MouaadO/synchronous-buck-converter/bom/Purchasing_BOM.xlsx

Synchronous buck converter · Bill of materials
37.8–58.8 V → 14.5 V / 4 A · 100 kHz · all through-hole · IFP Powertrain mini-project 2 · BOM matched to the LTspice file Project_2_saving.asc
 | Total excl. VAT | €42.97
 | VAT rate | 20%
 | Total incl. VAT | €51.57
Schematic ref (LTspice) | Simulated model | Description | Manufacturer | Manufacturer PN | Order qty | Retailer | Retailer PN | Unit € excl. VAT | Line € excl. VAT | Order link
Power stage
Lin | 10µ | 10 µH inductor · Irms 2.7 A · Isat 6.7 A · 48 mΩ | Bourns | RLB0914-100KL | 1 | Farnell | 2321765 | €0.340 | €0.34 | Open Farnell ↗ (https://fr.farnell.com/bourns/rlb0914-100kl/inductance-10uh-2-7a-10-radial/dp/2321765)
Cin, Cout | 100µ | 100 µF capacitor · 100 V · low-ESR electrolytic (FR series) · 1.5 A ripple at 100 kHz / 105 °C · ESR 84 mΩ · Ø10×20 mm · 5 mm pitch | Panasonic | EEU-FR2A101B | 2 | Mouser | 667-EEU-FR2A101B | €1.220 | €2.44 | Open Mouser ↗ (https://www.mouser.fr/ProductDetail/Panasonic/EEU-FR2A101B?qs=u16ybLDytRZBZOsu6DbX5Q%3D%3D)
C7 | 10µ | 10 µF capacitor · 100 V · 20% electrolytic · damping branch | Panasonic | ECA2AM100 | 1 | Farnell | 9693912 | €0.210 | €0.21 | Open Farnell ↗ (https://fr.farnell.com/panasonic/eca2am100/cap-10-f-100v-20/dp/9693912)
R10 | 0.5 | 0.5 Ω resistor · 5% · 1 W | Yageo | FMP100JR-52-0R51 | 1 | Mouser | 603-FMP100JR-52-0R51 | €0.335 | €0.34 | Open Mouser ↗ (https://www.mouser.fr/fr/ProductDetail/YAGEO/FMP100JR-52-0R51?qs=oypCK0zG324JEEoMrYb%2F4w%3D%3D)
M1, M2 | IPP086N10N3 | N-MOSFET · 100 V · 8.6 mΩ · 80 A · Qg 55 nC · TO-220 | Infineon | IPP086N10N3GXKSA1 | 2 | Farnell | 2709893 | €2.650 | €5.30 | Open Farnell ↗ (https://fr.farnell.com/search?st=2709893)
D5 | MBRS1100 | Schottky rectifier · 100 V · 1 A · DO-41 | onsemi | MBR1100RLG | 1 | Mouser | 863-MBR1100RLG | €0.697 | €0.70 | Open Mouser ↗ (https://www.mouser.fr/fr/ProductDetail/onsemi/MBR1100RLG?qs=3JMERSakebqji%252BYhJ0BmMg%3D%3D)
Rshunt, Rshunt2 | 10m | 10 mΩ current sense resistor · 1% | Riedon (Bourns) | MT2B-0R01F1 | 2 | DigiKey | 696-1734-ND | €2.410 | €4.82 | Open DigiKey ↗ (https://www.digikey.fr/fr/products/detail/riedon-products-by-bourns/MT2B-0R01F1/6021851)
D11 | BZX84C15L | Zener Diodes 15 Volt 1.3 Watt | Vishay Semiconductors | 1N4744A-TAP | 1 | Mouser | 78-1N4744A-TAP | €0.335 | €0.34 | Open Mouser ↗ (https://www.mouser.fr/en/ProductDetail/Vishay-Semiconductors/1N4744A-TAP?qs=aho4taYYNurtiIjeOjc3Cg%3D%3D)
Gate drivers (M1 high side, M2 low side)
D1 | MMSD4148 | Ultrafast diode · 200 V · 1 A · 50 ns · DO-41 (bootstrap) | Vishay | UF4003-E3/54 | 5 | Farnell | 9551646 | €0.706 | €3.53 | Open Farnell ↗ (https://fr.farnell.com/vishay/uf4003-e3-54/diode-fast-1a-200v/dp/9551646)
C1 | 1µ | 1 µF capacitor · 50 V · X7R · 10% (bootstrap) | KEMET | C330C105K5R5TA7301 | 1 | Mouser | 80-C330C105K5R7301 | €0.576 | €0.58 | Open Mouser ↗ (https://www.mouser.fr/fr/ProductDetail/KEMET/C330C105K5R5TA7301?qs=17iMOMbff9UVwtQMImnwKQ%3D%3D)
Q1, Q2, Q3, Q5, Q7, Q8 | BC846B / 2SC4061K | NPN transistor · 160 V · 600 mA · 0.625 W · hFE ≥ 80 (all NPN: inverters, level shift, totem tops) | onsemi | 2N5551TA | 6 | DigiKey | 2N5551TAFSCT-ND | €0.270 | €1.62 | Open Digikey ↗ (https://www.digikey.fr/fr/products/detail/onsemi/2N5551TA/973959)
Q4, Q6 | BC556B | PNP transistor · 150 V · 600 mA · 0.625 W · complement of 2N5551 (totem bottoms) | onsemi | 2N5401YBU | 2 | DigiKey | 2N5401YBUOS-ND | €0.260 | €0.52 | Open DigiKey ↗ (https://www.digikey.com/en/products/detail/onsemi/2N5401YBU/975298)
D8, D9, D10 | D (default) | Small-signal diode · 100 V · 150 mA · 4 ns · DO-35 | Vishay | 1N4148-TAP | 3 | Mouser | 78-1N4148-TAP | €0.224 | €0.67 | Open Mouser ↗ (https://www.mouser.fr/fr/ProductDetail/Vishay-Semiconductors/1N4148-TAP?qs=j6bfm3UnQnzzWicd%2FOfTEw%3D%3D)
R7, R31 | 10 | 10 Ω resistor · 1% · 0.25 W (gate) | Yageo | MFR-25FBF52-10R | 2 | Mouser | 603-MFR-25FBF52-10R | €0.086 | €0.17 | Open Mouser ↗ (https://www.mouser.fr/fr/ProductDetail/YAGEO/MFR-25FBF52-10R?qs=oAGoVhmvjhxFEeFiVj%2FuSQ%3D%3D)
R4, R8, R26 | 4.7k | 4.7 kΩ resistor · 1% · 0.25 W | Yageo | MFR-25FBF52-4K7 | 3 | Mouser | 603-MFR-25FBF52-4K7 | €0.095 | €0.29 | Open Mouser ↗ (https://www.mouser.fr/fr/ProductDetail/YAGEO/MFR-25FBF52-4K7?qs=oAGoVhmvjhyEuU2iU0uA4w%3D%3D)
R9, R23, R29 | 2.2k | 2.2 kΩ resistor · 1% · 0.25 W | Yageo | MFR25SFTF52-2K2 | 3 | DigiKey | MFR25SFTF52-2K2 | €0.100 | €0.30 | Open DigiKey ↗ (https://www.digikey.com/en/products/detail/yageo/MFR25SFTF52-2K2/9144509)
C2, C5, C8, C9, C10 | 1n | 1 nF capacitor · 50 V · X7R · 10% (speed-up) | Vishay | K102K15X7RF5TL2 | 5 | Mouser | 594-K102K15X7RF5TL2 | €0.224 | €1.12 | Open Mouser ↗ (https://www.mouser.fr/fr/ProductDetail/Vishay-BC-Components/K102K15X7RF5TL2?qs=YhDfSRCt1jTMC0SrHWnr8A%3D%3D)
Shared resistors
R2, R5, R15, R16, R22, R24, R25, R27, R30, Rgate1, Rgate2 | 10k | 10 kΩ resistor · 1% · 0.25 W | Yageo | MFR-25FBF52-10K | 11 | Mouser | 603-MFR-25FBF52-10K | €0.086 | €0.95 | Open Mouser ↗ (https://www.mouser.fr/fr/ProductDetail/YAGEO/MFR-25FBF52-10K?qs=oAGoVhmvjhxY0mVN9GL5Pg%3D%3D)
R12, R17, R20 | 1k | 1 kΩ resistor · 1% · 0.25 W | Yageo | MFR-25FBF52-1K | 3 | Mouser | 603-MFR-25FBF52-1K | €0.086 | €0.26 | Open Mouser ↗ (https://www.mouser.fr/fr/ProductDetail/YAGEO/MFR-25FBF52-1K?qs=oAGoVhmvjhwCAC47ReWjsQ%3D%3D)
Measurements for the Arduino
R1 | 120k | 120 kΩ resistor · 1% · 0.25 W (Vin ÷13) | Yageo | MFR-25FBF52-120K | 1 | Mouser | 603-MFR-25FBF52-120K | €0.181 | €0.18 | Open Mouser ↗ (https://www.mouser.fr/fr/ProductDetail/YAGEO/MFR-25FBF52-120K?qs=gt1LBUVyoHklbx%2FXO5OUuA%3D%3D)
R3 | 30k | 30.1 kΩ resistor · 1% · 0.25 W (Vout ÷4) | Yageo | MFR-25FBF52-30K1 | 1 | Mouser | 603-MFR-25FBF52-30K1 | €0.086 | €0.09 | Open Mouser ↗ (https://www.mouser.fr/fr/ProductDetail/YAGEO/MFR-25FBF52-30K1?qs=oAGoVhmvjhzLhbq61dvLWw%3D%3D)
R13, R14 | 4.99k | 4.99 kΩ resistor · 1% · 0.25 W | Yageo | MFR-25FBF52-4K99 | 2 | Mouser | 603-MFR-25FBF52-4K99 | €0.086 | €0.17 | Open Mouser ↗ (https://www.mouser.fr/fr/ProductDetail/YAGEO/MFR-25FBF52-4K99?qs=oAGoVhmvjhxwNFLO0SXfyA%3D%3D)
R11, R21 | 100k | 100 kΩ resistor · 0.1% · 0.25 W | SEI Stackpole | RNF14BTC100K | 2 | Mouser | 708-RNF14BTC100K | €0.108 | €0.22 | Open Mouser ↗ (https://www.mouser.fr/fr/ProductDetail/SEI-Stackpole/RNF14BTC100K?qs=IPgv5n7u5QaLRFL3DdmKJA%3D%3D)
R18 | 100k | 100 kΩ resistor · 1% · 0.25 W | Yageo | MFR-25FBF52-100K | 1 | Mouser | 603-MFR-25FBF52-100K | €0.086 | €0.09 | Open Mouser ↗ (https://www.mouser.fr/fr/ProductDetail/YAGEO/MFR-25FBF52-100K?qs=oAGoVhmvjhxAqZbyE%2Fs9bg%3D%3D)
R19 | 2k | 2 kΩ resistor · 1% · 0.25 W | Yageo | MFR-25FBF52-2K | 1 | Mouser | 603-MFR-25FBF52-2K | €0.086 | €0.09 | Open Mouser ↗ (https://www.mouser.fr/fr/ProductDetail/YAGEO/MFR-25FBF52-2K?qs=oAGoVhmvjhym1upYmL0LFQ%3D%3D)
U1, U2, U4 (+1 spare) | LT1490 | Dual Over-The-Top op amp · 44 V inputs · rail-to-rail | Analog Devices | LT1490ACN8#PBF | 2 | Farnell | LT1490ACN8#PBF | €5.280 | €10.56 | Open Farnell ↗ (https://fr.farnell.com/search?st=LT1490ACN8%23PBF)
D2, D3, D4, D6, D7 | UMZ5_1N | 5.1 V Zener diode · 500 mW · DO-35 (ADC clamp) | Vishay | 1N5231B-TR | 5 | Mouser | 78-1N5231B | €0.421 | €2.10 | Open Mouser ↗ (https://www.mouser.fr/fr/ProductDetail/Vishay-Semiconductors/1N5231B-TR?qs=TNTIDjy6APpam96idN6gNg%3D%3D)
C3 | 1.2n | 1.2 nF ceramic capacitor · 200 V | KEMET | C317C122J2G5TA | 1 | Mouser | 80-C317C122J2G5TA | €0.636 | €0.64 | Open Mouser ↗ (https://www.mouser.fr/c/?q=C315C122F2G5TA)
C4 | 2.2n | 2.2 nF capacitor · 25 V · C0G · 1% (filter) | KEMET | C315C222F3G5TA | 1 | Mouser | 80-C315C222F3G5TA | €1.190 | €1.19 | Open Mouser ↗ (https://www.mouser.fr/fr/ProductDetail/KEMET/C315C222F3G5TA?qs=h3%2Fj8evtlm1j8Co3p3vnQw%3D%3D)
C6 | 100n | 100 nF capacitor · 50 V · X7R · 10% | Vishay | K104K15X7RF5TL2 | 1 | Mouser | 594-K104K15X7RF5TL2 | €0.267 | €0.27 | Open Mouser ↗ (https://www.mouser.fr/fr/ProductDetail/Vishay-BC-Components/K104K15X7RF5TL2?qs=sYfpZ29HcUR83i3HiPAFlA%3D%3D)
Connectors
Headers 10-pin ×2 | — (not simulated) | Male header · 1×10 · 2.54 mm · tin | Wurth Elektronik | 61304011121 | 1 | Mouser | 710-61304011121 | €1.320 | €1.32 | Open Mouser ↗ (https://www.mouser.fr/fr/ProductDetail/Wurth-Elektronik/61304011121?qs=PhR8RmCirEZJqAFOTF3fMQ%3D%3D)
Supply terminals ×3 | — (not simulated) | Terminal block · screw type · 2 pos · 5.08 mm | Same Sky | TB007-508-02BE | 3 | DigiKey | TB007-508-02BE | €0.530 | €1.59 | Open DigiKey ↗ (https://www.digikey.fr/fr/products/detail/same-sky-formerly-cui-devices/TB007-508-02BE/10064127)
Heat sink for M1 | — (not simulated) | Heat Sinks Channel Heat Sink for TO220, Vertical, 24.4 Degree C/W | Aavid | 577202B04000G | 1 | Mouser | 532-577202B04000G | €1.090 | €1.09 | Open Mouser ↗ (https://www.mouser.fr/en/ProductDetail/Aavid/577202B04000G?qs=UkxmsQ8q2oXEh26f6ITVdQ%3D%3D)
