MouaadO/synchronous-buck-converter/pcb/3dmodels/M3_Heatsink_Assembly_Hardware.step

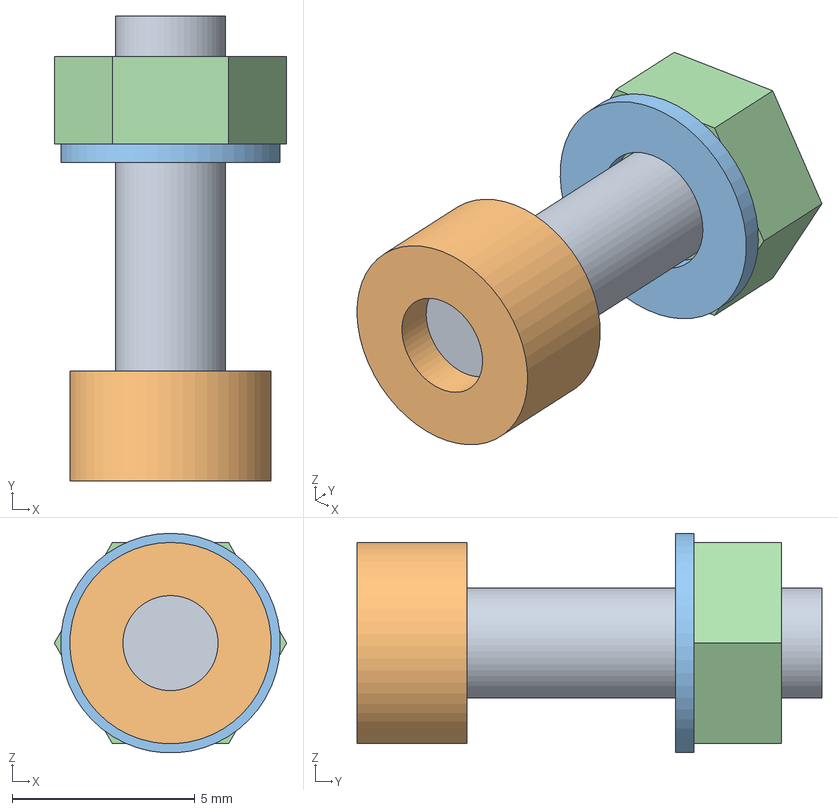
[picture p9: CAD file, 2026-11-05]
pcb/3dmodels/M3_Heatsink_Assembly_Hardware.step
6.35 x 12.7 x 5.99 mm
