MouaadO/synchronous-buck-converter/pcb/3dmodels/M1_Heatsink_Assembly_Preview.step

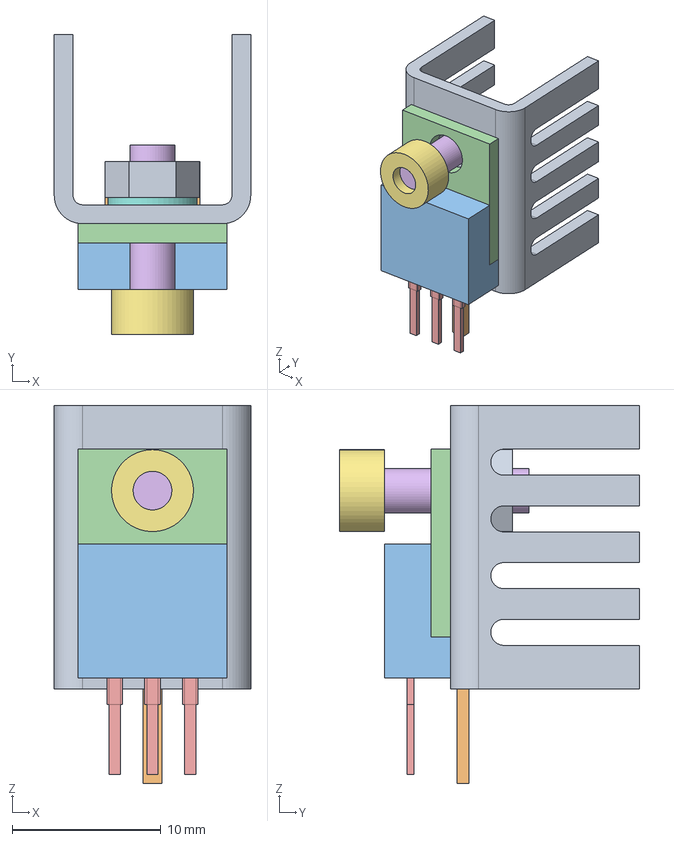
[picture p10: CAD file, 2026-11-05]
pcb/3dmodels/M1_Heatsink_Assembly_Preview.step
13.2 x 20.1 x 25.4 mm
