MouaadO/synchronous-buck-converter/pcb/3dmodels/Manufacturer_CAD/TB007-508-02BE.step

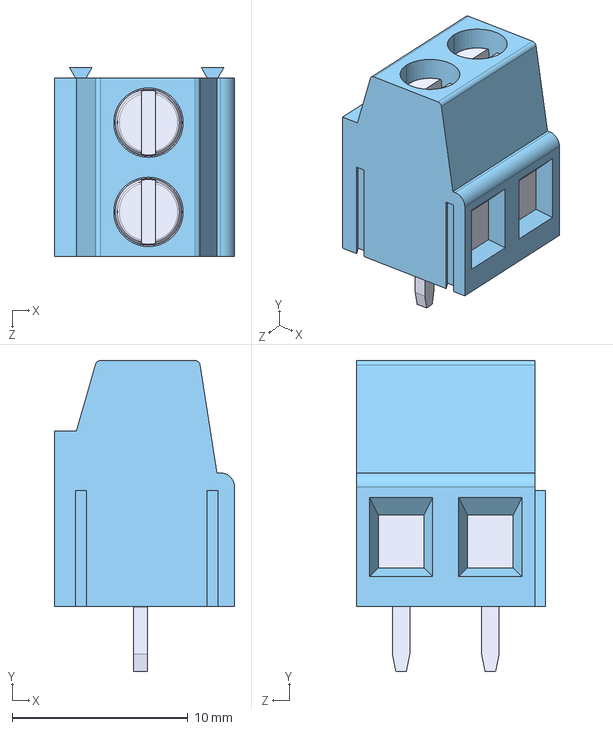
[picture p11: CAD file, 2026-11-05]
pcb/3dmodels/Manufacturer_CAD/TB007-508-02BE.step
10.2 x 17.7 x 10.8 mm
