MouaadO/synchronous-buck-converter/pcb/3dmodels/Boyd_577202B04000G_Detailed.step

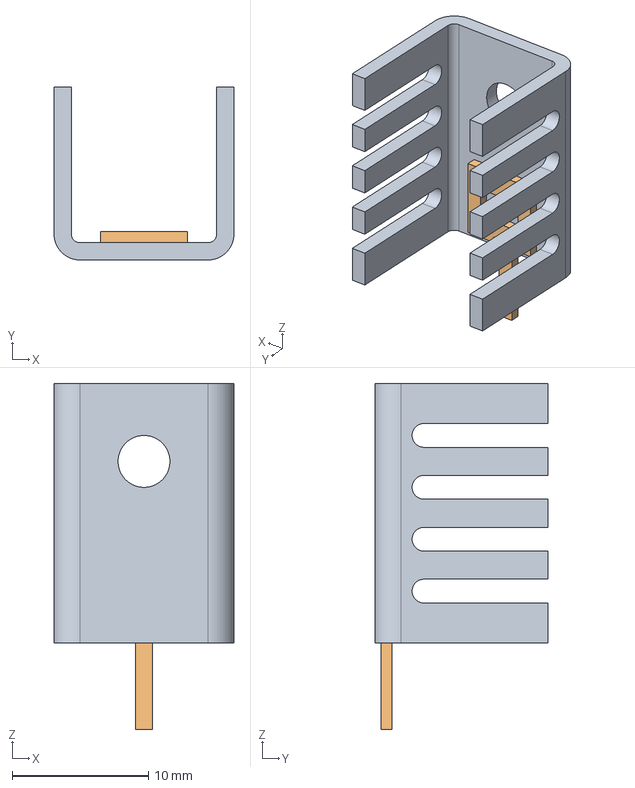
[picture p12: CAD file, 2026-11-05]
pcb/3dmodels/Boyd_577202B04000G_Detailed.step
13.2 x 12.7 x 25.4 mm
