MouaadO/synchronous-buck-converter/pcb/3dmodels/Manufacturer_CAD/C330C105K5R5TA7301.step

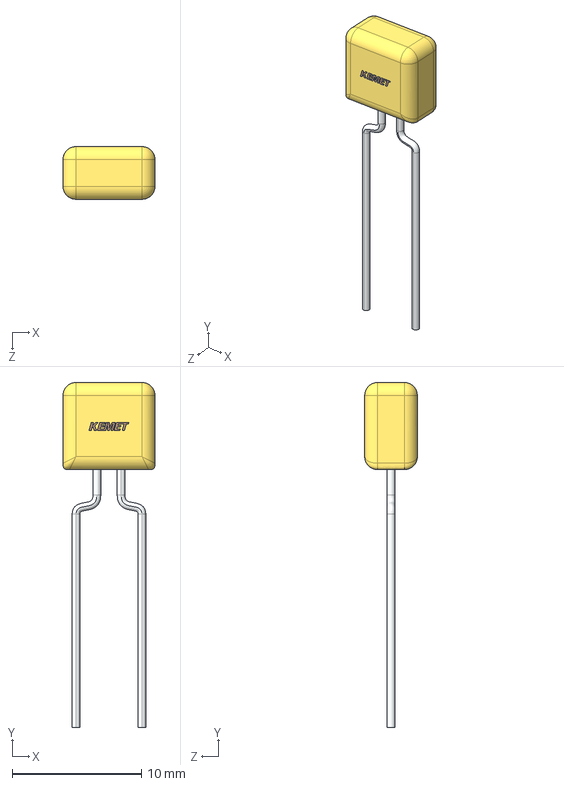
[picture p13: CAD file, 2026-11-05]
pcb/3dmodels/Manufacturer_CAD/C330C105K5R5TA7301.step
7.11 x 26.7 x 4.08 mm
