MouaadO/synchronous-buck-converter/pcb/3dmodels/Manufacturer_CAD/C317C122J2G5TA.step

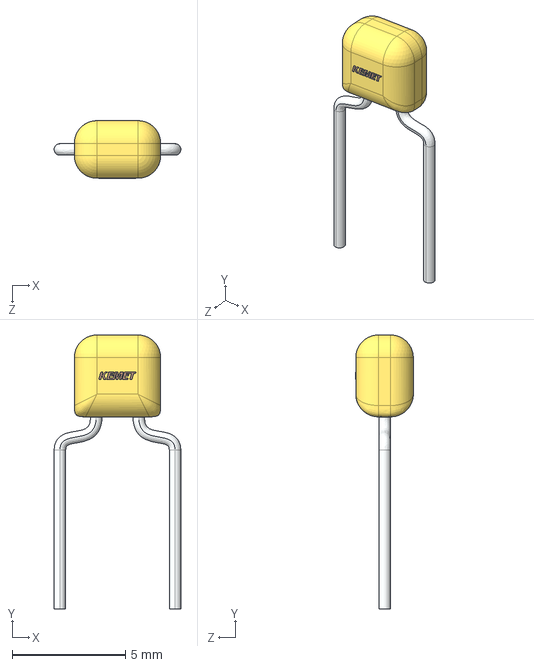
[picture p14: CAD file, 2026-11-05]
pcb/3dmodels/Manufacturer_CAD/C317C122J2G5TA.step
5.59 x 12.1 x 2.54 mm
