MouaadO/synchronous-buck-converter/pcb/3dmodels/Infineon_IPP086N10N3G_Mounted.step

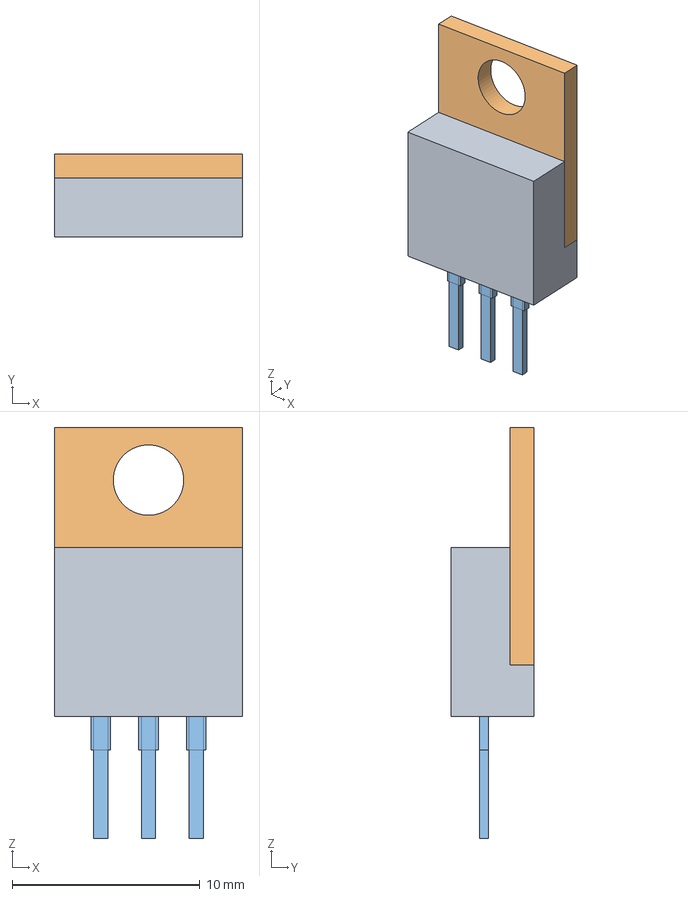
[picture p15: CAD file, 2026-11-05]
pcb/3dmodels/Infineon_IPP086N10N3G_Mounted.step
10.0 x 4.44 x 21.9 mm
