MouaadO/synchronous-buck-converter/pcb/3dmodels/Manufacturer_CAD/C315C222F3G5TA.step

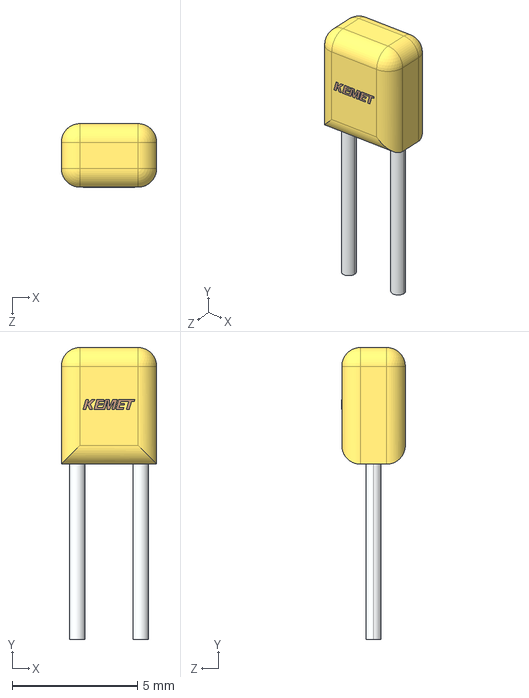
[picture p16: CAD file, 2026-11-05]
pcb/3dmodels/Manufacturer_CAD/C315C222F3G5TA.step
3.81 x 11.7 x 2.54 mm
