MouaadO/synchronous-buck-converter/simulation/Newinputfilter.asc

C1: cap; 1µ
C2: cap; 1n
C3: cap; 1.2n
C4: cap; 2.2n
C5: cap; 1n
C6: cap; 100n
C8: cap; 1n
C9: cap; 1n
C10: cap; 1n
Cin: cap; 100µ
Cout: cap; 100µ
D1: diode; MMSD4148
D2: zener; UMZ5_1N
D3: zener; UMZ5_1N
D4: zener; UMZ5_1N
D5: schottky; MBRS1100
D6: zener; UMZ5_1N
D7: zener; UMZ5_1N
D8: diode
D9: diode
D10: diode
D11: zener; BZX84C15L
Lin: ind; 10µ; Rser=1m
Lout: ind; 130µ; Rser=1m
M1: nmos; IPP086N10N3
M2: nmos; IPP086N10N3
Q1: npn; BC846B
Q2: npn; BC846B
Q3: npn; 2SC4061K
Q4: pnp; BC556B
Q5: npn; BC846B
Q6: pnp; BC556B
Q7: npn; 2SC4061K
Q8: npn; BC846B
R1: res; 120k
R2: res; 10k
R3: res; 30k
R4: res; 4.7k
R5: res; 10k
R7: res; 10
R8: res; 4.7k
R9: res; 2.2k
R10: res; 0.5
R11: res; 100k
R12: res; 1k
R13: res; 4.99k
R14: res; 4.99k
R15: res; 10k
R16: res; 10k
R17: res; 1k
R18: res; 100k
R19: res; 2k
R20: res; 1k
R21: res; 100k
R22: res; 10k
R23: res; 2.2k
R24: res; 10k
R25: res; 10k
R26: res; 4.7k
R27: res; 10k
R29: res; 2.2k
R30: res; 10k
R31: res; 10
Rgate1: res; 10k
Rgate2: res; 10k
Rload: res; 3.625
Rshunt2: res; 10m
Rshunt: res; 10m
U1: LT1490
U2: LT1490
U4: LT1490
V1: voltage; PULSE(0 5 0 10n 10n {Ton} {T})
V2: voltage; PULSE(0 5 {Ton+td} 10n 10n {T-Ton-2*td} {T})
Vcom: voltage; 12
Vin: voltage; 58.8
Named nets: 0, PWM1, Vout_Analogue, PWM2, Driver_Supply, Cboot, Id, Gnd_Id, Ifiltered, Vin, Id_Mes, Vout, Gnd_Vout, Vin_Analogue, M1G, M2G
.tran 5m uic
.param Vout=14.5 Vin=58.8 T=10u td=500n
.param Ton={((Vout+1.45)/Vin)*T}
