MouaadO/synchronous-buck-converter/pcb/Synchronous_Buck.kicad_pcb

## KiCad design pcb/Synchronous_Buck.kicad_pcb (2026-11-05)

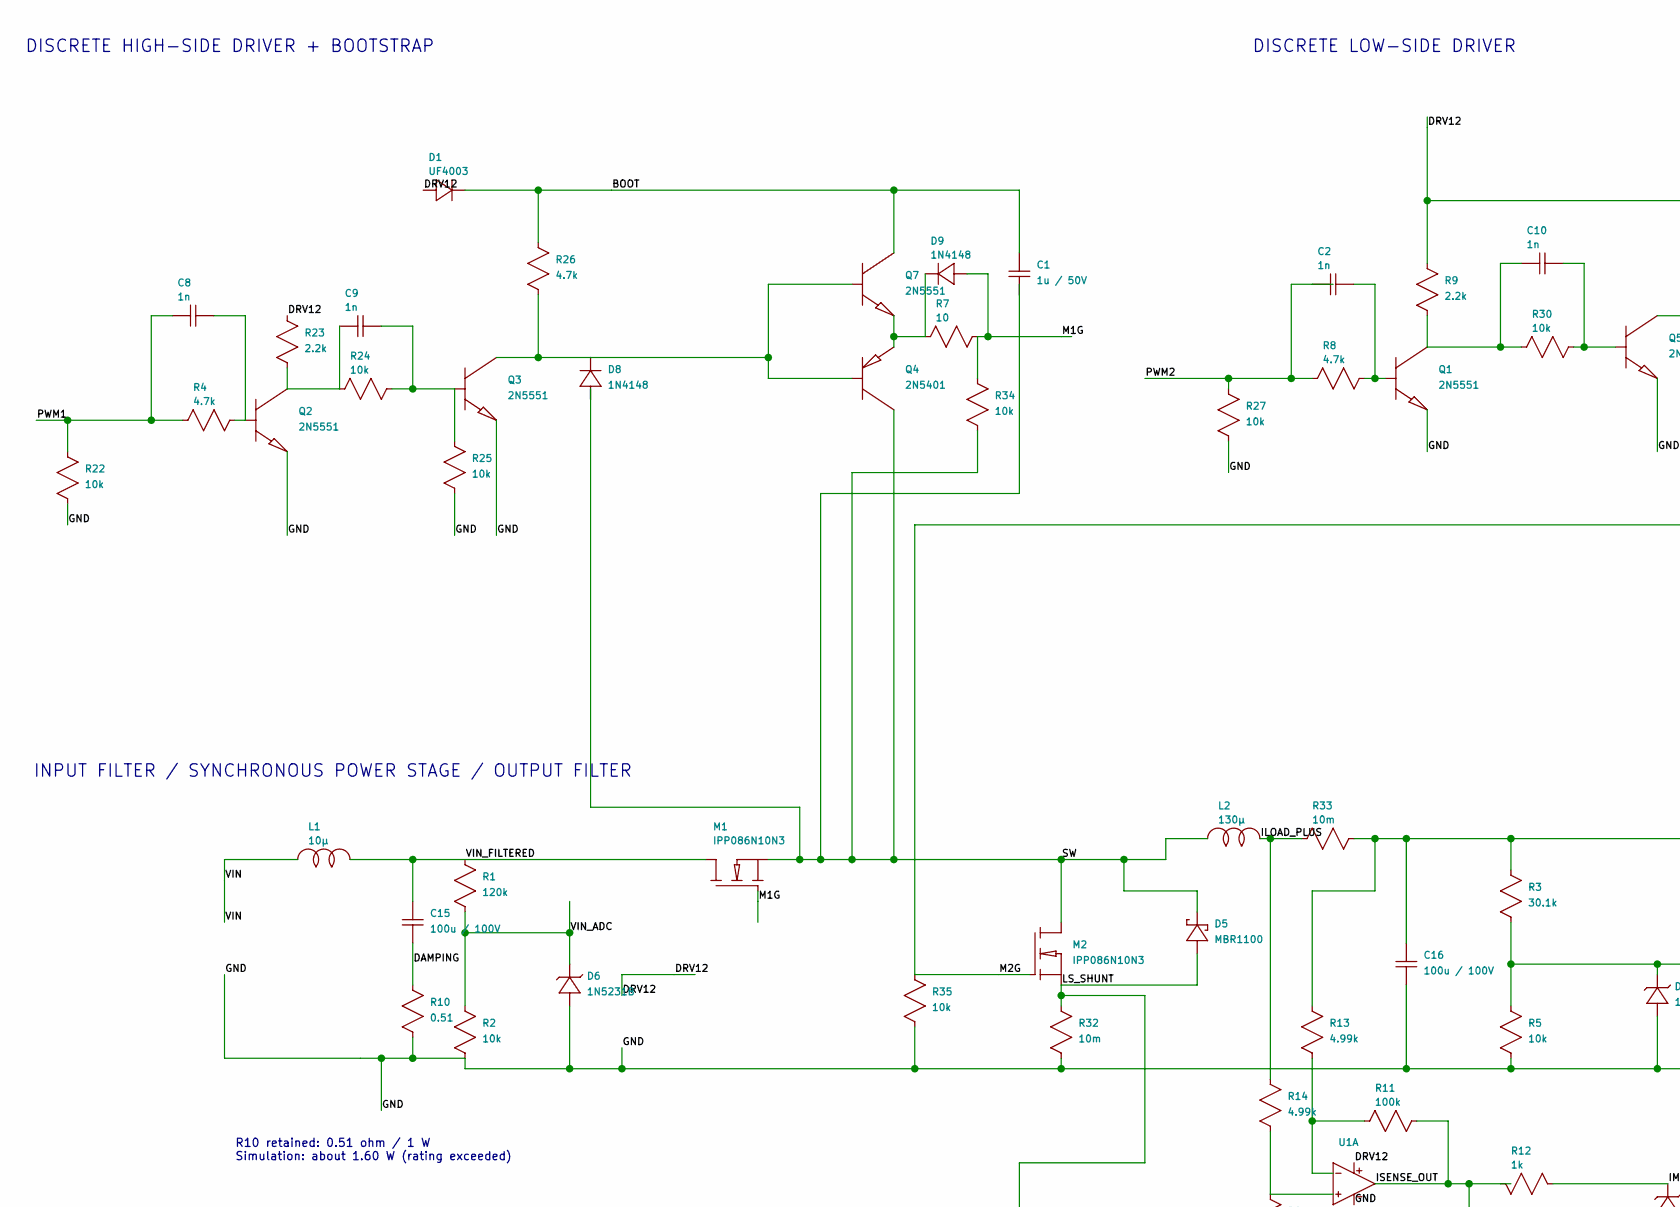
[picture p17: schematic Synchronous_Buck.kicad_sch, Synchronous buck converter - discrete drivers, part in row 1, column 1]

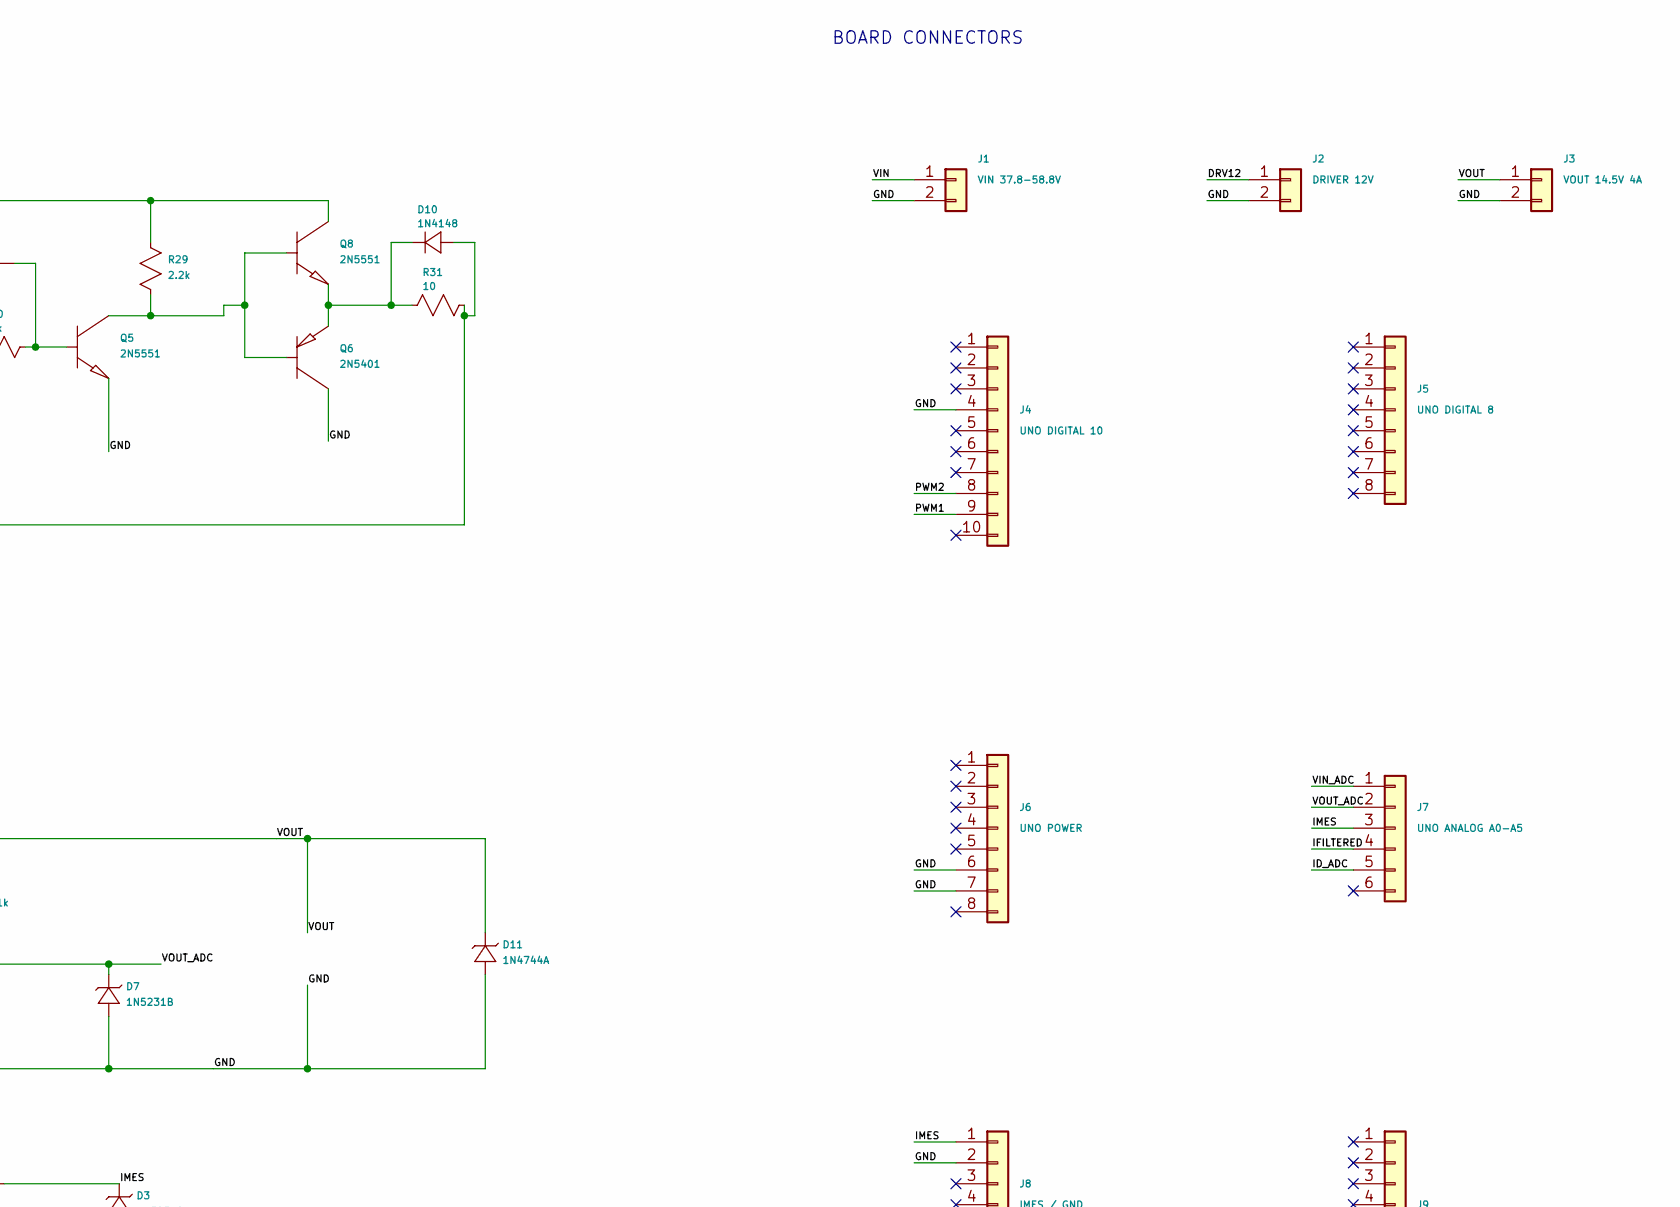
[picture p18: schematic Synchronous_Buck.kicad_sch, Synchronous buck converter - discrete drivers, part in row 1, column 2]

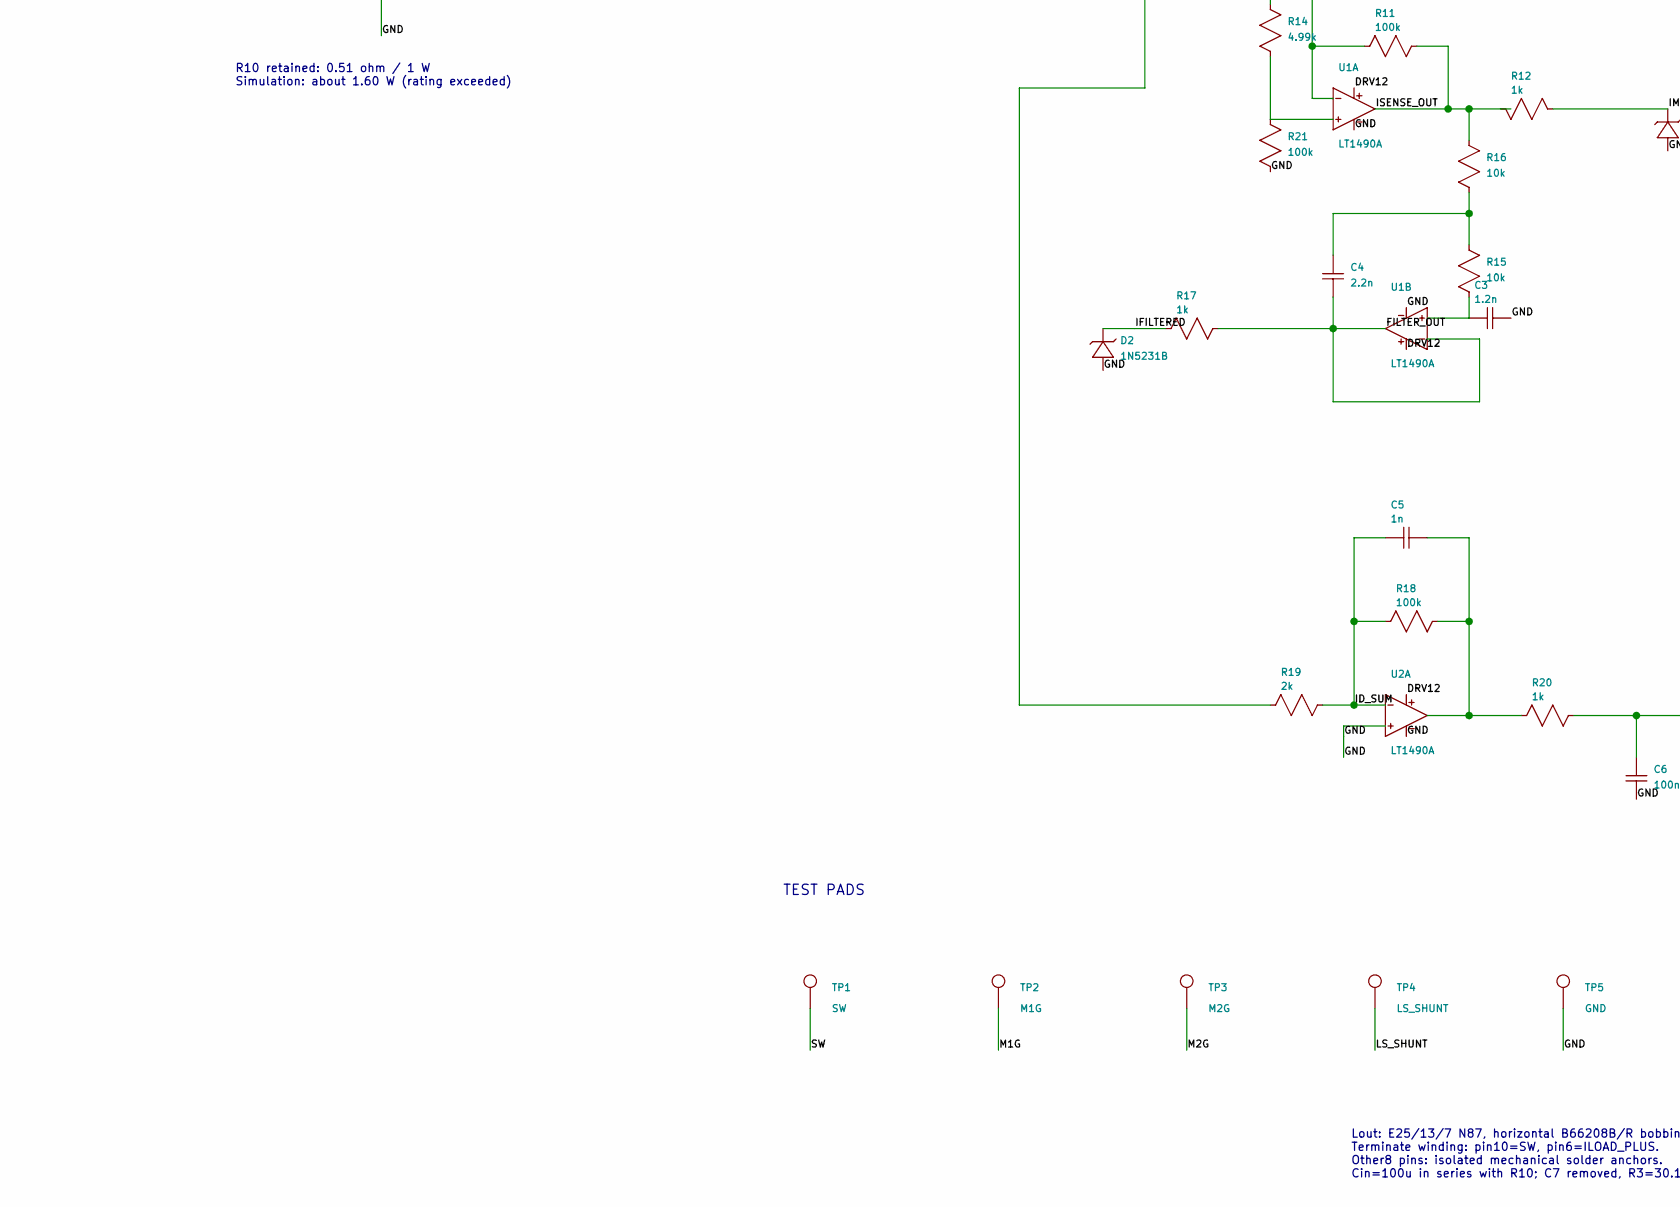
[picture p19: schematic Synchronous_Buck.kicad_sch, Synchronous buck converter - discrete drivers, part in row 2, column 1]

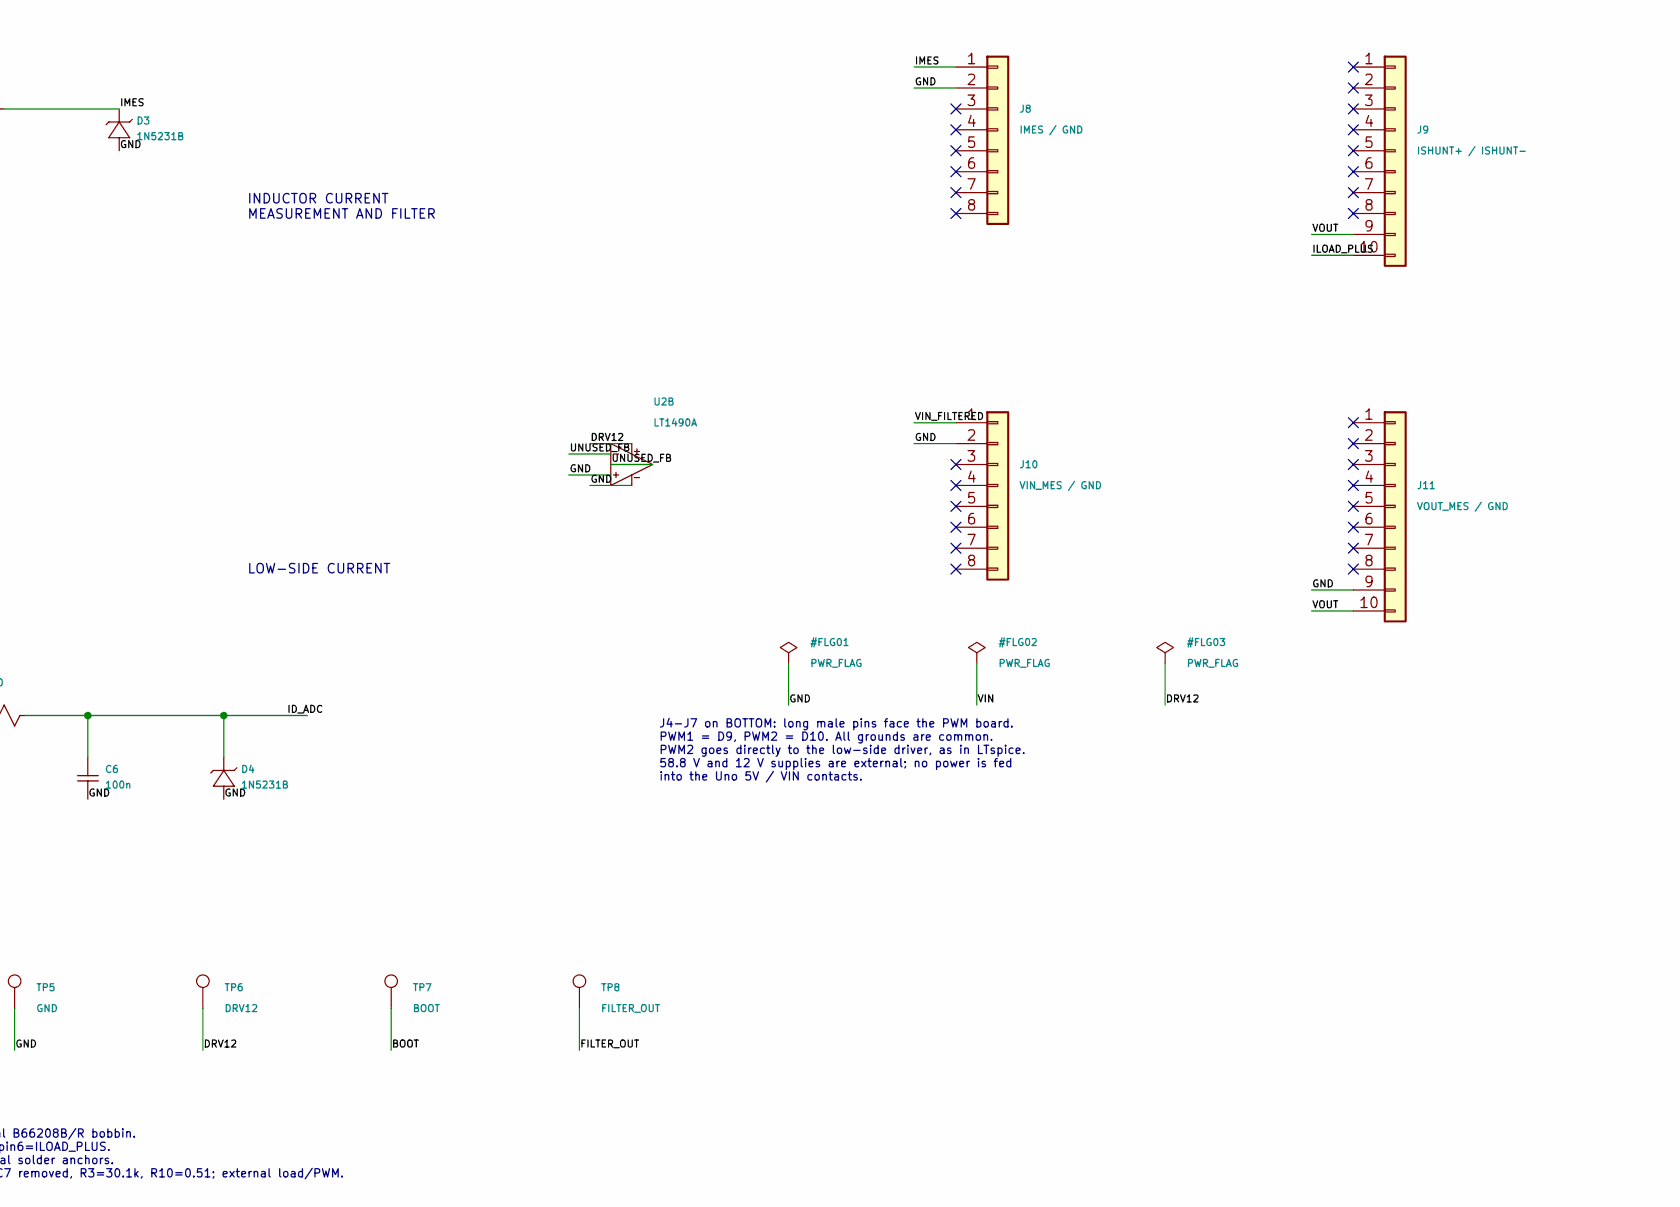
[picture p20: schematic Synchronous_Buck.kicad_sch, Synchronous buck converter - discrete drivers, part in row 2, column 2]

Parts:
C1: 1u / 50V; KEMET_C330_P5.08; MPN C330C105K5R5TA7301
C2, C5, C8, C9, C10: 1n; Vishay_K15_P2.5; MPN K102K15X7RF5TL2
C3: 1.2n; KEMET_C317_P5.08; MPN C317C122J2G5TA
C4: 2.2n; KEMET_C315_P2.54; MPN C315C222F3G5TA
C6: 100n; Vishay_K15_P2.5; MPN K104K15X7RF5TL2
C15, C16: 100u / 100V; CP_Radial_D10.0mm_P5.00mm; MPN EEU-FR2A101B
D1: UF4003; D_DO-41_SOD81_P12.70mm_Horizontal; MPN UF4003-E3/54
D2, D3, D4, D6, D7: 1N5231B; D_DO-35_SOD27_P10.16mm_Horizontal; MPN 1N5231B-TR
D5: MBR1100; D_DO-41_SOD81_P12.70mm_Horizontal; MPN MBR1100RLG
D8, D9, D10: 1N4148; D_DO-35_SOD27_P10.16mm_Horizontal; MPN 1N4148-TAP
D11: 1N4744A; D_DO-41_SOD81_P12.70mm_Horizontal; MPN 1N4744A-TAP
J1: VIN 37.8-58.8V; TerminalBlock_CUI_TB007-508-02_1x02_P5.08mm_Horizontal; MPN TB007-508-02BE
J2: DRIVER 12V; TerminalBlock_CUI_TB007-508-02_1x02_P5.08mm_Horizontal; MPN TB007-508-02BE
J3: VOUT 14.5V 4A; TerminalBlock_CUI_TB007-508-02_1x02_P5.08mm_Horizontal; MPN TB007-508-02BE
J4: UNO DIGITAL 10; WE_1x10_P2.54; MPN 61304011121 cut to 10
J5: UNO DIGITAL 8; WE_1x08_P2.54; MPN 61304011121 cut to 8
J6: UNO POWER; WE_1x08_P2.54; MPN 61304011121 cut to 8
J7: UNO ANALOG A0-A5; WE_1x06_P2.54; MPN 61304011121 cut to 6
J8: IMES / GND; WE_1x08_P2.54; MPN 61304011121 cut to 8
J9: ISHUNT+ / ISHUNT-; WE_1x10_P2.54; MPN 61304011121 cut to 10
J10: VIN_MES / GND; WE_1x08_P2.54; MPN 61304011121 cut to 8
J11: VOUT_MES / GND; WE_1x10_P2.54; MPN 61304011121 cut to 10
L1: 10µ; Bourns_RLB0914_P5; MPN RLB0914-100KL
L2: 130µ; TDK_E25_B66208BR_Horizontal_10Pin_Winding10_6; MPN Hand-wound E25/13/7 N87
M1: IPP086N10N3; IPP086_with_577202; MPN IPP086N10N3GXKSA1
M2: IPP086N10N3; TO-220-3_Vertical; MPN IPP086N10N3GXKSA1
Q1, Q2, Q3, Q5, Q7, Q8: 2N5551; TO-92_Inline_Wide; MPN 2N5551TA
Q4, Q6: 2N5401; TO-92_Inline_Wide; MPN 2N5401YBU
R1: 120k; R_Axial_DIN0207_L6.3mm_D2.5mm_P10.16mm_Horizontal; MPN MFR-25FBF52-120K
R2, R5, R15, R16, R22, R24, R25, R27, R30, R34, R35: 10k; R_Axial_DIN0207_L6.3mm_D2.5mm_P10.16mm_Horizontal; MPN MFR-25FBF52-10K
R3: 30.1k; R_Axial_DIN0207_L6.3mm_D2.5mm_P10.16mm_Horizontal; MPN MFR-25FBF52-30K1
R4, R8, R26: 4.7k; R_Axial_DIN0207_L6.3mm_D2.5mm_P10.16mm_Horizontal; MPN MFR-25FBF52-4K7
R7, R31: 10; R_Axial_DIN0207_L6.3mm_D2.5mm_P10.16mm_Horizontal; MPN MFR-25FBF52-10R
R9, R23, R29: 2.2k; R_Axial_DIN0204_L3.6mm_D1.6mm_P5.08mm_Horizontal; MPN MFR25SFTF52-2K2
R10: 0.51; R_Axial_DIN0207_L6.3mm_D2.5mm_P10.16mm_Horizontal; MPN FMP100JR-52-0R51
R11, R21: 100k; R_Axial_DIN0207_L6.3mm_D2.5mm_P10.16mm_Horizontal; MPN RNF14BTC100K
R12, R17, R20: 1k; R_Axial_DIN0207_L6.3mm_D2.5mm_P10.16mm_Horizontal; MPN MFR-25FBF52-1K
R13, R14: 4.99k; R_Axial_DIN0207_L6.3mm_D2.5mm_P10.16mm_Horizontal; MPN MFR-25FBF52-4K99
R18: 100k; R_Axial_DIN0207_L6.3mm_D2.5mm_P10.16mm_Horizontal; MPN MFR-25FBF52-100K
R19: 2k; R_Axial_DIN0207_L6.3mm_D2.5mm_P10.16mm_Horizontal; MPN MFR-25FBF52-2K
R32, R33: 10m; MT2B_20.32mm; MPN MT2B-0R01F1
TP1: SW; TestPoint_Pad_D2.0mm; MPN PCB copper pad
TP2: M1G; TestPoint_Pad_D2.0mm; MPN PCB copper pad
TP3: M2G; TestPoint_Pad_D2.0mm; MPN PCB copper pad
TP4: LS_SHUNT; TestPoint_Pad_D2.0mm; MPN PCB copper pad
TP5: GND; TestPoint_Pad_D2.0mm; MPN PCB copper pad
TP6: DRV12; TestPoint_Pad_D2.0mm; MPN PCB copper pad
TP7: BOOT; TestPoint_Pad_D2.0mm; MPN PCB copper pad
TP8: FILTER_OUT; TestPoint_Pad_D2.0mm; MPN PCB copper pad
U1, U2: LT1490A; DIP-8_W7.62mm; MPN LT1490ACN8#PBF

Connections:
/BOOT: C1.1 (A), D1.1 (-), Q7.3 (C), R26.1 (A), TP7.1
/DAMPING: C15.2 (B), R10.1 (A)
/DRV12: D1.2 (+), J2.1, Q8.3 (C), R9.1 (A), R23.1 (A), R29.1 (A), TP6.1, U1.8 (V+), U2.8 (V+)
/FILTER_OUT: C4.2 (B), R17.1 (A), TP8.1, U1.6 (In-), U1.7 (OUT)
/GND: C3.1 (A), C6.2 (B), C16.2 (B), D2.2 (+), D3.2 (+), D4.2 (+), D6.2 (+), D7.2 (+), D11.2 (+), J1.2, J2.2, J3.2, J4.4, J6.6, J6.7, J8.2, J10.2, J11.9, Q1.1 (E), Q2.1 (E), Q3.1 (E), Q5.1 (E), Q6.3 (C), R2.2 (B), R5.2 (B), R10.2 (B), R21.2 (B), R22.2 (B), R25.2 (B), R27.2 (B), R32.2 (B), R35.2 (B), TP5.1, U1.4 (V-), U2.3 (In+), U2.4 (V-), U2.5 (In+)
/ID_ADC: C6.1 (A), D4.1 (-), J7.5, R20.1 (A)
/ID_SUM: C5.2 (B), R18.2 (B), R19.1 (A), U2.2 (In-)
/IFILTERED: D2.1 (-), J7.4, R17.2 (B)
/ILOAD_PLUS: J9.10, L2.6 (B), R14.1 (A), R33.2 (B)
/IMES: D3.1 (-), J7.3, J8.1, R12.2 (B)
/ISENSE_OUT: R11.1 (A), R12.1 (A), R16.1 (A), U1.1 (OUT)
/LS_SHUNT: D5.2 (+), M2.3 (S), R19.2 (B), R32.1 (A), TP4.1
/M1G: D9.2 (+), M1.1 (G), R7.1 (A), R34.1 (A), TP2.1
/M2G: D10.2 (+), M2.1 (G), R31.1 (A), R35.1 (A), TP3.1
/PWM1: C8.2 (B), J4.9, R4.2 (B), R22.1 (A)
/PWM2: C2.2 (B), J4.8, R8.2 (B), R27.1 (A)
/SW: C1.2 (B), D5.1 (-), D8.2 (+), L2.10 (A), M1.3 (S), M2.2 (D), Q4.3 (C), R34.2 (B), TP1.1
/UNUSED_FB: U2.6 (In-), U2.7 (OUT)
/VIN: J1.1, L1.1 (A)
/VIN_ADC: D6.1 (-), J7.1, R1.2 (B), R2.1 (A)
/VIN_FILTERED: C15.1 (A), J10.1, L1.2 (B), M1.2 (D), R1.1 (A)
/VOUT: C16.1 (A), D11.1 (-), J3.1, J9.9, J11.10, R3.1 (A), R13.1 (A), R33.1 (A)
/VOUT_ADC: D7.1 (-), J7.2, R3.2 (B), R5.1 (A)
unnamed: C2.1 (A), Q1.2 (B), R8.1 (A)
unnamed: C3.2 (B), R15.2 (B), U1.5 (In+)
unnamed: C4.1 (A), R15.1 (A), R16.2 (B)
unnamed: C5.1 (A), R18.1 (A), R20.2 (B), U2.1 (OUT)
unnamed: C8.1 (A), Q2.2 (B), R4.1 (A)
unnamed: C9.1 (A), Q3.2 (B), R24.1 (A), R25.1 (A)
unnamed: C9.2 (B), Q2.3 (C), R23.2 (B), R24.2 (B)
unnamed: C10.1 (A), Q5.2 (B), R30.1 (A)
unnamed: C10.2 (B), Q1.3 (C), R9.2 (B), R30.2 (B)
unnamed: D8.1 (-), Q3.3 (C), Q4.2 (B), Q7.2 (B), R26.2 (B)
unnamed: D9.1 (-), Q4.1 (E), Q7.1 (E), R7.2 (B)
unnamed: D10.1 (-), Q6.1 (E), Q8.1 (E), R31.2 (B)
unnamed: Q5.3 (C), Q6.2 (B), Q8.2 (B), R29.2 (B)
unnamed: R11.2 (B), R13.2 (B), U1.2 (In-)
unnamed: R14.2 (B), R21.1 (A), U1.3 (In+)

Notes on the sheet:
DISCRETE HIGH-SIDE DRIVER + BOOTSTRAP
DISCRETE LOW-SIDE DRIVER
INPUT FILTER / SYNCHRONOUS POWER STAGE / OUTPUT FILTER
INDUCTOR CURRENT MEASUREMENT AND FILTER
LOW-SIDE CURRENT
BOARD CONNECTORS
J4-J7 on BOTTOM: long male pins face the PWM board. PWM1 = D9, PWM2 = D10. All grounds are common. PWM2 goes directly to the low-side driver, as in LTspice. 58.8 V and 12 V supplies are external; no power is fed into the Uno 5V / VIN contacts.
TEST PADS
Lout: E25/13/7 N87, horizontal B66208B/R bobbin. Terminate winding: pin10=SW, pin6=ILOAD_PLUS. Other8 pins: isolated mechanical solder anchors. Cin=100u in series with R10; C7 removed, R3=30.1k, R10=0.51; external load/PWM.
R10 retained: 0.51 ohm / 1 W Simulation: about 1.60 W (rating exceeded)

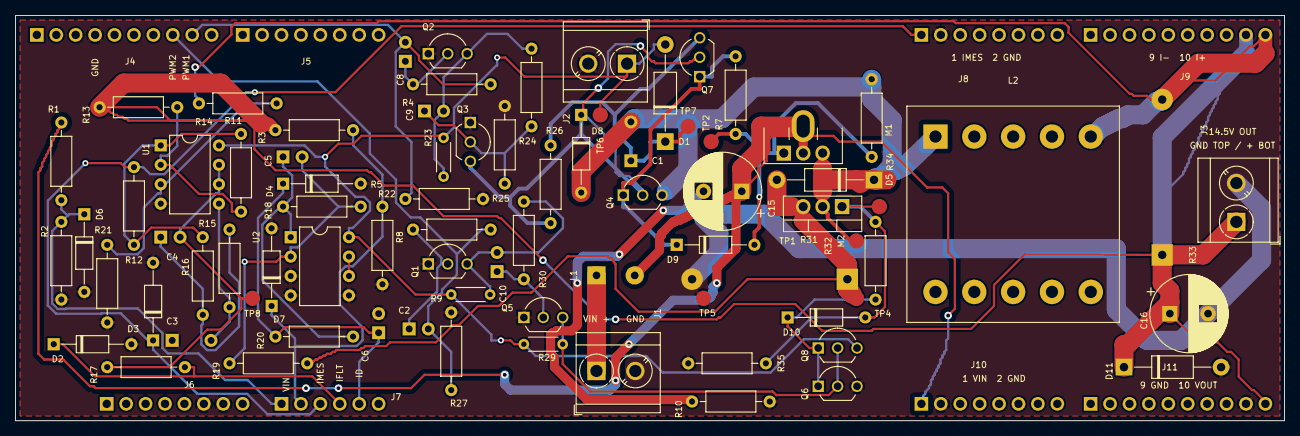
[picture p21: board Synchronous_Buck.kicad_pcb from above]

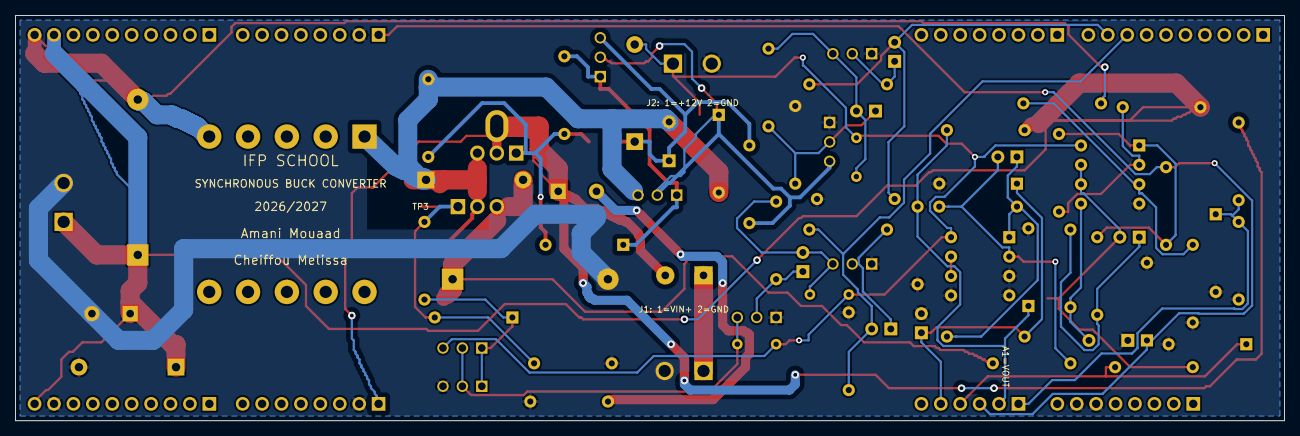
[picture p22: board Synchronous_Buck.kicad_pcb from below]

Board: 2 copper layers, 166.0 x 53.0 mm, 88 parts (4 on the bottom side), 38 nets.
