MouaadO/synchronous-buck-converter/(commit log)

2026-11-05 Add 58 W synchronous buck converter hardware, simulation and 3D gallery
    [Board_Assembly.csv, Boyd_577202B04000G_Detailed.step, C315C222F3G5TA.step, C317C122J2G5TA.step, C330C105K5R5TA7301.step, Infineon_IPP086N10N3G_Mounted.step, M1_Heatsink_Assembly_Preview.step, M3_Heatsink_Assembly_Hardware.step]
2026-11-05 Remove non-LTspice optional capacitors and refresh PCB views
    [Board_Assembly.csv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]
2026-11-05 Clean PCB annotations and align connector references
    [Synchronous_Buck-B_Cu.gbl, Synchronous_Buck-B_Mask.gbs, Synchronous_Buck-B_Silkscreen.gbo, Synchronous_Buck-Edge_Cuts.gm1, Synchronous_Buck-F_Cu.gtl, Synchronous_Buck-F_Mask.gts, Synchronous_Buck-F_Silkscreen.gto, Synchronous_Buck-NPTH.drl]
2026-11-05 Remove buck PCB mounting holes and refresh fabrication files
    [Board_Assembly.csv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]
2026-11-06 Organize schematic into boxed stages on one sheet
    [Synchronous_Buck-B_Cu.gbl, Synchronous_Buck-B_Mask.gbs, Synchronous_Buck-B_Silkscreen.gbo, Synchronous_Buck-Edge_Cuts.gm1, Synchronous_Buck-F_Cu.gtl, Synchronous_Buck-F_Mask.gts, Synchronous_Buck-F_Silkscreen.gto, Synchronous_Buck-NPTH.drl]
